arthur-wirjo/reaction-wheel-inverted-pendulum/BOM.md

### Control Board BOM

| Category | Description / Value | Manufacturer & Part Number | LCSC / Part ID | Designator | Qty |
| :--- | :--- | :--- | :--- | :--- | :--- |
| **Capacitors** | 15pF, 0603, C0G, 100V | muRata GCM1885C2A150FA16D | C882576 | C16, C17 | 2 |
| | 75pF, 0603, C0G, 50V | FOJAN FCC0603N750J500CT | C53308514 | C23 | 1 |
| | 10nF, 0603, X7R, 100V | Samsung Electro-Mechanics CL10B103KC8NNNC | C84709 | C28 | 1 |
| | 100nF, 0603, X7R, 25V | Samsung Electro-Mechanics CL10B104KA8NNNC | C1590 | C1, C5, C7, C8, C10–C15, C18–C20 | 13 |
| | 100nF, 0805, X7R, 100V | Samsung Electro-Mechanics CL21B104KCFWPNE | C307361 | C25 | 1 |
| | 1uF, 0603, X7R, 50V | Samsung Electro-Mechanics CL10B105KB8NQNC | C5199872 | C4, C6, C26, C27 | 4 |
| | 2.2uF, 0805, X7R, 25V | Samsung Electro-Mechanics CL21B225KAFNNNE | C19110 | C2, C3 | 2 |
| | 4.7uF, 1210, X7R, 50V | muRata GCM32ER71H475KA55L | C126618 | C9, C29 | 2 |
| | 10uF, 1210, X7R, 50V | Taiyo Yuden UMK325AB7106KMHP | C386166 | C24 | 1 |
| | 22uF, 1210, X7R, 25V | Samsung Electro-Mechanics CL32B226KAJNNNE | C309062 | C21, C22 | 2 |
| **Resistors** | 0Ω, 0603, Jumper | FOJAN FRC0603F0000TS | C2906974 | R2 | 1 |
| | 43Ω, 1210, 1%, 500mW | FOJAN FRC1210F43R0TS | C2999573 | R18, R19 | 2 |
| | 49.9Ω, 0603, 1%, 100mW | YAGEO RC0603FR-0749R9L | C114625 | R7 | 1 |
| | 1kΩ, 0603, 1%, 100mW | YAGEO RC0603FR-071KL | C22548 | R4, R12, R15, R16 | 4 |
| | 2.2kΩ, 0603, 1%, 200mW | UNI-ROYAL HP03W5F2201T5E | C2759425 | R13 | 1 |
| | 5.1kΩ, 0603, 1%, 100mW | YAGEO AC0603FR-075K1L | C125891 | R5, R6, R21 | 3 |
| | 10kΩ, 0603, 1%, 100mW | FH ABD03K1002FT | C5139509 | R1, R3, R17, R20, R22 | 5 |
| | 10kΩ, 0603, 1%, 200mW | YAGEO RC0603FR-7W10KL | C859110 | R14 | 1 |
| | 13.3kΩ, 0603, 1%, 100mW | UNI-ROYAL 0603WAF1332T5E | C25952 | R9 | 1 |
| | 100kΩ, 0805, 1%, 125mW | FH RS-05K1003FT | C118847 | R8 | 1 |
| | 105kΩ, 0603, 1%, 100mW | FOJAN FRC0603F1053TS | C2933128 | R11 | 1 |
| | 511kΩ, 0603, 1%, 100mW | FOJAN FRC0603F5113TS | C2930114 | R10 | 1 |
| **Inductors** | 10uH, Isat > 3.5A, Irms > 3A | TDK VLS6045EX-100M | C360734 | L1 | 1 |
| **Ferrite Bead**| 600Ω @ 100MHz, 0603 | muRata BLM18SP601SH1D | C1512133 | FB1 | 1 |
| **LEDs** | Green, 0603, SMD LED | YONGYUTAI YLED0603G | C19273151 | D2, D5 | 2 |
| | Red, 0603, SMD LED | YONGYUTAI YLED0603R | C19171390 | D3, D6 | 2 |
| | Blue, 0603, SMD LED | YONGYUTAI YLED0603B | C19171394 | D4 | 1 |
| **Crystal** | 12pF @ 25MHz | YXC Crystal Oscillators X322525MOB4SI | C9006 | - | 1 |
| **Button** | SMD-4P | XUNPU TS-1002S-05026C | C455110 | - | 3 |
| **Connectors** | XT60PW-F | - | - | - | 1 |
| | XT30PW-F | - | - | - | 1 |
| | XT30U-M | - | - | - | 1 |
| | Phoenix KF2EDGR-3.81-2P (male bent needle) | - | - | - | 1 |
| | Phoenix KF2EDGR-3.81-2P (female plug) | - | - | - | 1 |
| | 6-pin JST-GH | - | - | - | 1 |
| | 5-pin 2.54 pitch jumper | - | - | - | 1 |
| | USB-C Receptacle | HOAUC HYCW498-USBC16-735B | C42400252 | - | 1 |
| **ICs** | Microcontroller | ST STM32H743VIT6 | C114409 | - | 1 |
| | Buck Converter 24V-to-5V | TI TPS54302DDCR | C311983 | - | 1 |
| | LDO 5V-to-3.3V | MICRONE ME6211A33PG-N | C236673 | - | 1 |
| | FDCAN-compatible transceiver | ZHHXDZ TJA1051T/3/1J-HX | C53326728 | - | 1 |
| | USB ESD Protection Array | ST USBLC6-2SC6 | C7519 | - | 1 |

### Encoder Board BOM

| Category | Description / Value | Manufacturer & Part Number | LCSC / Part ID | Designator | Qty |
| :--- | :--- | :--- | :--- | :--- | :--- |
| **ICs** | Magnetic Encoder | ams AS5047P-ATSM | C962063 | - | 1 |
| **Capacitors** | 100nF, 0603, X7R, 25V | Samsung Electro-Mechanics CL10B104KA8NNNC | C1590 | C1 | 1 |
| | 1uF, 0603, X7R, 50V | Samsung Electro-Mechanics CL10B105KB8NQNC | C5199872 | C2 | 1 |
| **Resistors** | 0Ω, 0603, Jumper | FOJAN FRC0603F0000TS | C2906974 | R1 | 1 |
| | 10kΩ, 0603, 1%, 100mW | FH ABD03K1002FT | C5139509 | R2, R3, R4 | 3 |
| **Connectors** | 6-pin JST-GH | - | - | - | 1 |
| | 6-pin JST-PH | - | - | - | 1 |

### Other Components (Cables, Motor, Mechanical)

| Category | Description / Value | Qty |
| :--- | :--- | :--- |
| **Cables** | 6-pin JST-GH (one sided) | 1 |
| | 6-pin JST-PH (double sided) | 1 |
| | 4-pin JST-PH (one sided) | 1 |
| | 4 wire Slip Ring, 10A rating | 1 |
| **Motor, ESC, Power** | TianYi 4006 380Kv drone BLDC motor | 1 |
| | Flipsky Mini VESC 6.7 Pro | 1 |
| **Mechanical** | Bearing 608-ZZ | 1 |
| | Main rig (3D printed with PLA/PLA+) | 1 |
