arthur-wirjo/reaction-wheel-inverted-pendulum/BOM_and_Schematics/control_board_PCB.csv

Reference | Qty | Value | Description | Manufacturer | MPN | LCSC | Footprint
C1, C5, C7, C8, C10, C11, C12, C13, C14, C15, C18, C19, C20 | 13 | 100nF | 0603, X7R, 25V | Samsung Electro-Mechanics | CL10B104KA8NNNC | C1590 | C_0603_1608Metric
C2, C3 | 2 | 2.2uF | 0805, X7R, 25V | Samsung Electro-Mechanics | CL21B225KAFNNNE | C19110 | C_0805_2012Metric
C4, C6, C26, C27 | 4 | 1uF | 0603, X7R, 50V | Samsung Electro-Mechanics | CL10B105KB8NQNC | C5199872 | C_0603_1608Metric
C9, C29 | 2 | 4.7uF | 1210, X7R, 50V | muRata | GCM32ER71H475KA55L | C126618 | C_1210_3225Metric
C16, C17 | 2 | 15pF | 0603, C0G, 100V | muRata | GCM1885C2A150FA16D | C882576 | C_0603_1608Metric
C21, C22 | 2 | 22uF | 1210, X7R, 25V | Samsung Electro-Mechanics | CL32B226KAJNNNE | C309062 | C_1210_3225Metric
C23 | 1 | 75pF | 0603, C0G, 50V | FOJAN | FCC0603N750J500CT | C53308514 | C_0603_1608Metric
C24 | 1 | 10uF | 1210, X7R, 50V | Taiyo Yuden | UMK325AB7106KMHP | C386166 | C_1210_3225Metric
C25 | 1 | 100nF | 0805, X7R, 100V | Samsung Electro-Mechanics | CL21B104KCFWPNE | C307361 | C_0805_2012Metric
C28 | 1 | 10nF | 0603, X7R, 100V | Samsung Electro-Mechanics | CL10B103KC8NNNC | C84709 | C_0603_1608Metric
CN1 | 1 | KF2EDGR-3.81-2P | Pluggable Terminal Block Header, 2-Pin, 3.81mm, Right Angle, THT | Cixi Kefa Elec | KF2EDGR-3.81-2P | C441182 | Phoenix_CONN-TH_2P-P3.81_KF2EDGR-3.81-2P
D1 | 1 | USBLC6-2SC6 | USB ESD Protection Array, SOT-23-6L | STMicroelectronics | USBLC6-2SC6 | C7519 | ESD_SOT-23-6
D2, D5 | 2 | Green | Green SMD LED, 0603 | YONGYUTAI | YLED0603G | C19273151 | LED_0603_1608Metric
D3, D6 | 2 | Red | Red SMD LED, 0603 | YONGYUTAI | YLED0603R | C19171390 | LED_0603_1608Metric
D4 | 1 | Blue | Blue SMD LED, 0603 | YONGYUTAI | YLED0603B | C19171394 | LED_0603_1608Metric
FB1 | 1 | 600Ω @ 100MHz | Ferrite Bead, 0603 | muRata | BLM18SP601SH1D | C1512133 | L_0603_1608Metric
J1 | 1 | SM06B-GHS-TBLFSN | 6-pin JST-GH Male Header (SMD) | JST | SM06B-GHS-TB(LF)(SN) | - | CONN_SM06B-GHS-TB_JST
J3 | 1 | Conn_01x05_Pin | 2.54mm pitch 5-pin male header, Horizontal | Generic | - | - | PinHeader_1x05_P2.54mm_Horizontal
L1 | 1 | 10uH | Shielded Power Inductor, Isat 3.9A, Irms 3.4A, 6x6mm | TDK | VLS6045EX-100M | C360734 | IND-SMD_L6.0-W6.0
R1, R3, R17, R20, R22 | 5 | 10kΩ | 0603, 1%, 100mW | FH | ABD03K1002FT | C5139509 | R_0603_1608Metric
R2 | 1 | 0Ω | 0603, Jumper | FOJAN | FRC0603F0000TS | C2906974 | R_0603_1608Metric
R4, R12, R15, R16 | 4 | 1kΩ | 0603, 1%, 100mW | YAGEO | RC0603FR-071KL | C22548 | R_0603_1608Metric
R5, R6, R21 | 3 | 5.1kΩ | 0603, 1%, 100mW | YAGEO | AC0603FR-075K1L | C125891 | R_0603_1608Metric
R7 | 1 | 49.9Ω | 0603, 1%, 100mW | YAGEO | RC0603FR-0749R9L | C114625 | R_0603_1608Metric
R8 | 1 | 100kΩ | 0805, 1%, 125mW | FH | RS-05K1003FT | C118847 | R_0805_2012Metric
R9 | 1 | 13.3kΩ | 0603, 1%, 100mW | UNI-ROYAL | 0603WAF1332T5E | C25952 | R_0603_1608Metric
R10 | 1 | 511kΩ | 0603, 1%, 100mW | FOJAN | FRC0603F5113TS | C2930114 | R_0603_1608Metric
R11 | 1 | 105kΩ | 0603, 1%, 100mW | FOJAN | FRC0603F1053TS | C2933128 | R_0603_1608Metric
R13 | 1 | 2.2kΩ | 0603, 1%, 200mW | UNI-ROYAL | HP03W5F2201T5E | C2759425 | R_0603_1608Metric
R14 | 1 | 10kΩ | 0603, 1%, 200mW | YAGEO | RC0603FR-7W10KL | C859110 | R_0603_1608Metric
R18, R19 | 2 | 43Ω | 1210, 1%, 500mW | FOJAN | FRC1210F43R0TS | C2999573 | R_1210_3225Metric
SW1, SW2, SW3 | 3 | TS-1002S-05026C | Tactile Switch, SPST, SMD-4P, 6x6x5mm | XUNPU | TS-1002S-05026C | C455110 | BTN_KEY-SMD_4P-L6.0-W6.0
U1 | 1 | STM32H743VIT6 | 32-bit ARM Cortex-M7 MCU, LQFP-100 | STMicroelectronics | STM32H743VIT6 | C114409 | MCU_LQFP100-14x14mm
U2 | 1 | TJA1051T/3/1J-HX | FDCAN-Compatible High-Speed CAN Transceiver, SOIC-8 | ZHHXDZ | TJA1051T/3/1J-HX | C53326728 | CAN_SOP-8
U3 | 1 | ME6211A33PG-N | LDO 5V-to-3.3V Voltage Regulator, 500mA, SOT-89 | MICRONE | ME6211A33PG-N | C236673 | LDO_SOT-89
U4 | 1 | XT60PW-F | XT60 PCB Power Connector, Female, Right Angle, THT | Changzhou Amass Elec | XT60PW-F | C428722 | XT60_TH_2P-XT60PW-F
U5 | 1 | TPS54302DDCR | Buck Converter 24V-to-5V, 3A, TSOT-23-6 | Texas Instruments | TPS54302DDCR | C311983 | BUCK_SOT-23-6
U6 | 1 | XT30PW-F | XT30 PCB Power Connector, Female, Right Angle, THT | Changzhou Amass Elec | XT30PW-F20.G.Y | C2913282 | CONN-TH_XT30PW-F-1
USB1 | 1 | HYCW498-USBC16-735B | USB-C Receptacle (USB 2.0, 16-pin, SMD) | HOAUC | HYCW498-USBC16-735B | C42400252 | USB-C-SMD_HYCW498-USBC16-735B
X1 | 1 | 25MHz | 25MHz SMD Crystal, 12pF, 3.2x2.5mm, 4-Pin | YXC | X322525MOB4SI | C9006 | CRYSTAL-SMD_4P-L3.2-W2.5-BL
