arthur-wirjo/reaction-wheel-inverted-pendulum/BOM_and_Schematics/encoder_board_PCB.csv

Reference | Qty | Value | Description | Manufacturer | MPN | LCSC | Footprint
C1 | 1 | 100nF | 0603, X7R, 25V | Samsung Electro-Mechanics | CL10B104KA8NNNC | C1590 | C_0603_1608Metric
C2 | 1 | 1uF | 0603, X7R, 50V | Samsung Electro-Mechanics | CL10B105KB8NQNC | C5199872 | C_0603_1608Metric
J1 | 1 | S6B-PH-SM4-TBLFSN | 6-pin JST-PH Male Header (SMD) | JST | S6B-PH-SM4-TB(LF)(SN) | - | CONN6_S6B-PH_JST
J2 | 1 | SM06B-GHS-TBLFSN | 6-pin JST-GH Male Header (SMD) | JST | SM06B-GHS-TB(LF)(SN) | - | CONN_SM06B-GHS-TB_JST
R1 | 1 | 0Ω | 0603, Jumper | FOJAN | FRC0603F0000TS | C2906974 | R_0603_1608Metric
R2, R3, R4 | 3 | 10kΩ | 0603, 1%, 100mW | FH | ABD03K1002FT | C5139509 | R_0603_1608Metric
U1 | 1 | AS5047P-ATSM | 14-bit Magnetic Rotary Position Sensor, TSSOP-14 | ams OSRAM | AS5047P-ATSM | C962063 | ENC_TSSOP14_OSM
