arthur-wirjo/reaction-wheel-inverted-pendulum/Mechanical_Design/Assembly.SLDASM

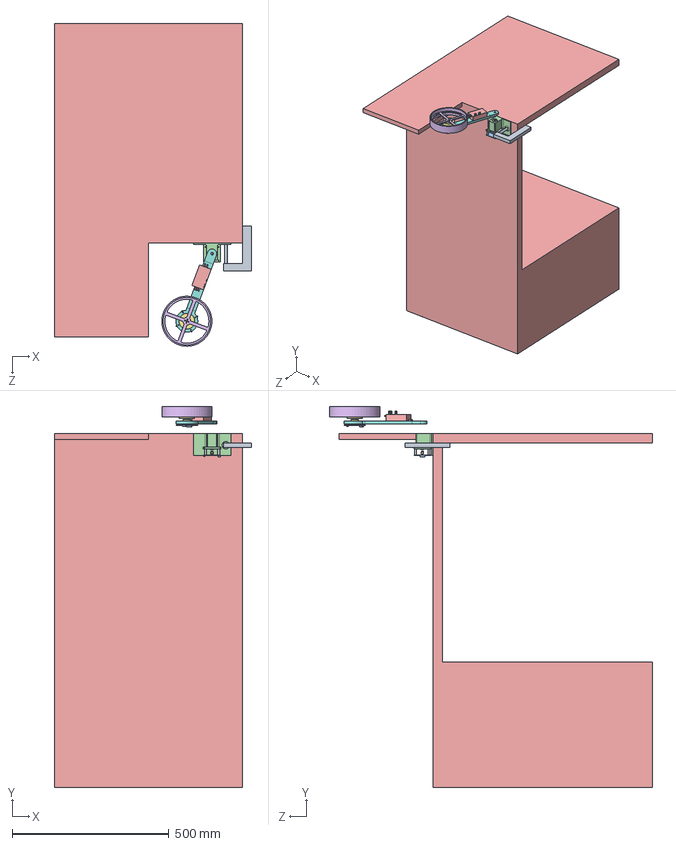
[picture p1: CAD file, 2026-11-14]
Mechanical_Design/Assembly.SLDASM
630.0 x 1216.0 x 1029.5 mm
Table
Base
bearing_spacer_01
SKF_608-2ZZ x 2
clamp
Arm
Motor
Wheel
VESC
encodeer_spacer_01 x 4
encoder board PCB x 2
magnet_coupler_SPI
encoder_spacer_02 x 4
