arthur-wirjo/reaction-wheel-inverted-pendulum/Component_EDA_Models/MagEnc_AS5047P/TSSOP14_OSM.step

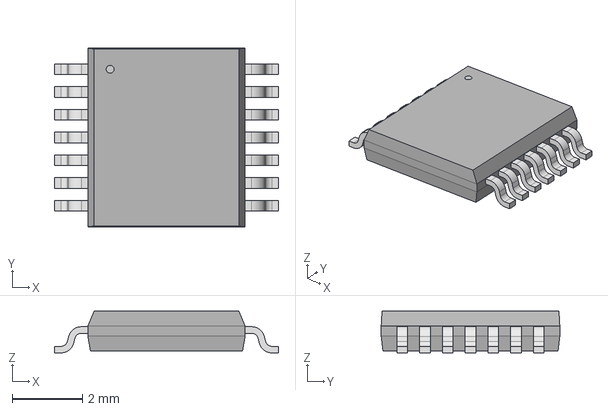
[picture p2: CAD file, 2026-10-11]
Component_EDA_Models/MagEnc_AS5047P/TSSOP14_OSM.step
6.40 x 5.11 x 1.20 mm
