arthur-wirjo/reaction-wheel-inverted-pendulum/Component_EDA_Models/STM32H743VIT6/LQFP100-14x14mm.step

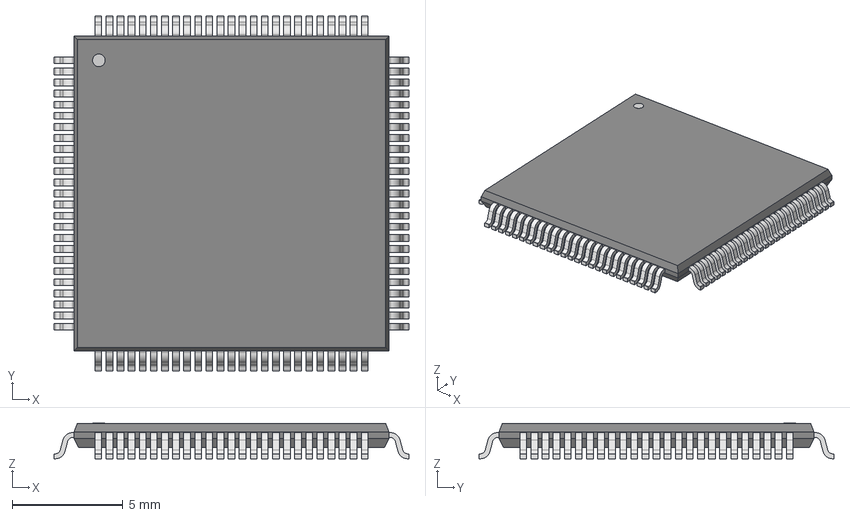
[picture p3: CAD file, 2026-10-11]
Component_EDA_Models/STM32H743VIT6/LQFP100-14x14mm.step
16.0 x 16.0 x 1.60 mm
