arthur-wirjo/reaction-wheel-inverted-pendulum/Mechanical Design/3D Prints/magnet_coupler_SPI.STEP

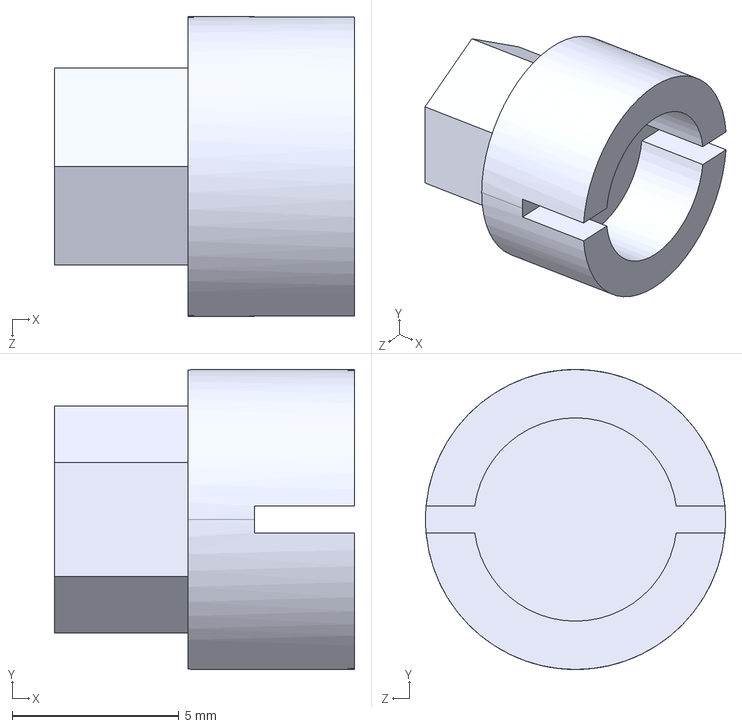
[picture p4: CAD file, 2026-11-08]
Mechanical Design/3D Prints/magnet_coupler_SPI.STEP
9.00 x 9.00 x 9.00 mm
