arthur-wirjo/reaction-wheel-inverted-pendulum/Mechanical Design/bearing_spacer_01.SLDPRT

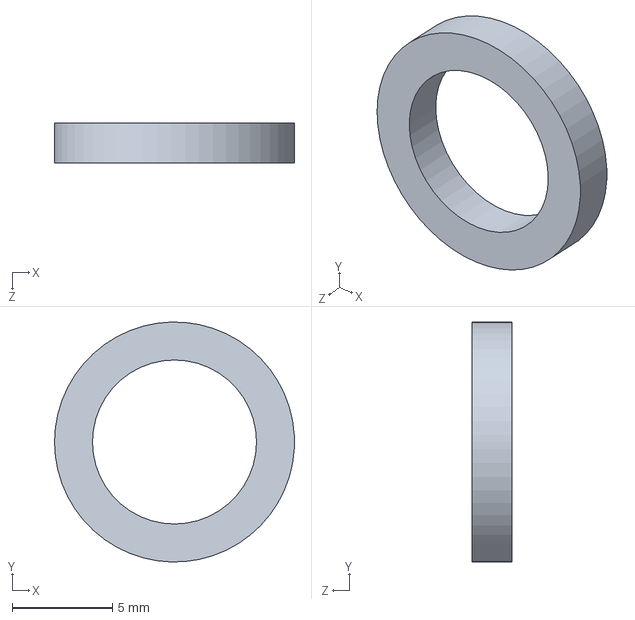
[picture p5: CAD file, 2026-11-08]
Mechanical Design/bearing_spacer_01.SLDPRT
12.0 x 12.0 x 2.00 mm
