arthur-wirjo/reaction-wheel-inverted-pendulum/Mechanical_Design/3D Prints/4X_encodeer_spacer_01.STEP

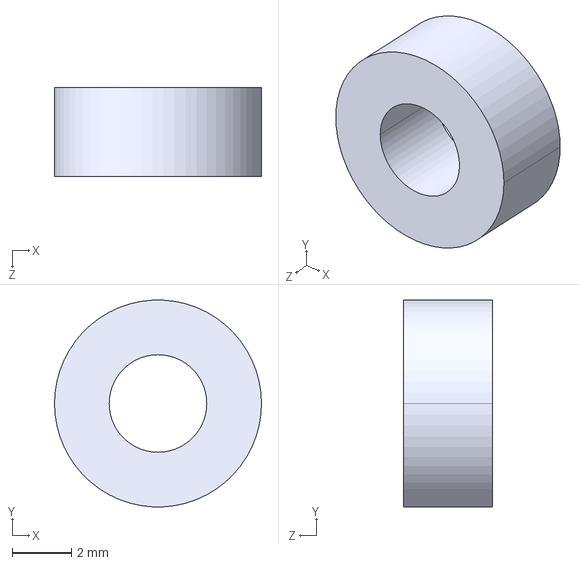
[picture p6: CAD file, 2026-11-14]
Mechanical_Design/3D Prints/4X_encodeer_spacer_01.STEP
7.00 x 6.99 x 3.00 mm
