arthur-wirjo/reaction-wheel-inverted-pendulum/Mechanical Design/3D Prints/Wheel.STEP

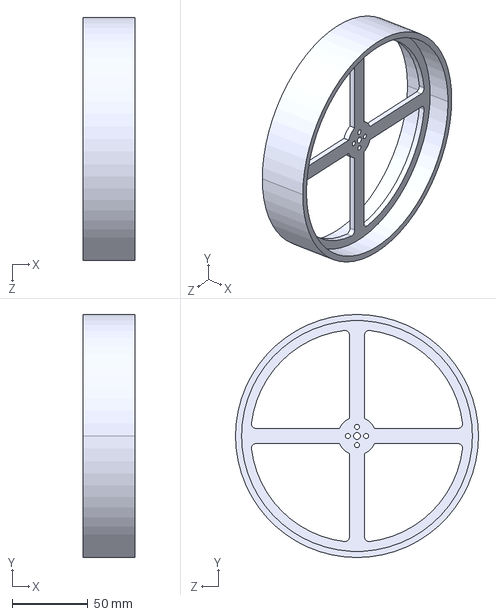
[picture p7: CAD file, 2026-11-08]
Mechanical Design/3D Prints/Wheel.STEP
34.0 x 160.0 x 160.0 mm
