arthur-wirjo/reaction-wheel-inverted-pendulum/Mechanical_Design/3D Prints/Base.STEP

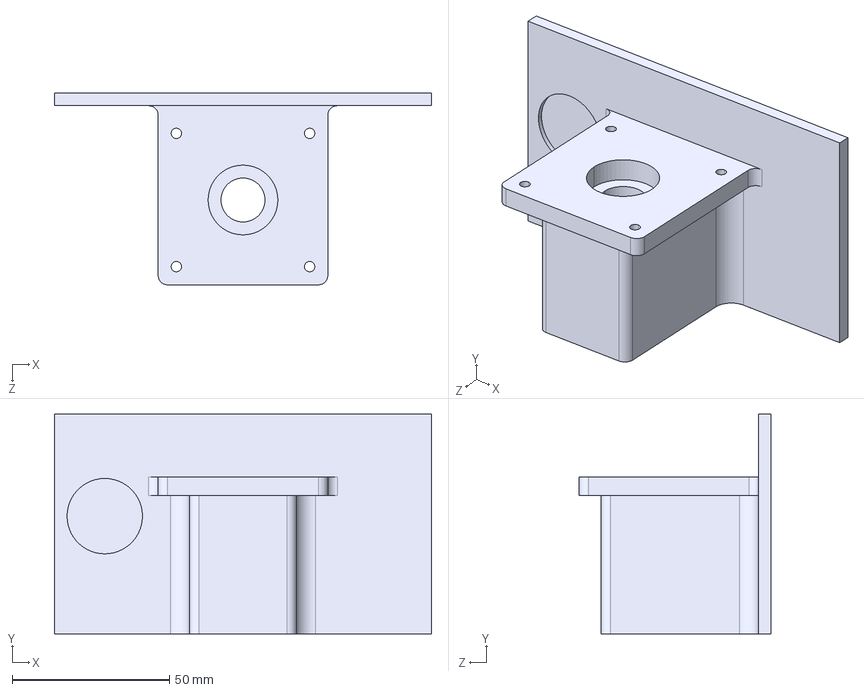
[picture p8: CAD file, 2026-11-14]
Mechanical_Design/3D Prints/Base.STEP
120.0 x 70.0 x 61.0 mm
