arthur-wirjo/reaction-wheel-inverted-pendulum/Mechanical Design/3D Prints/Arm.STEP

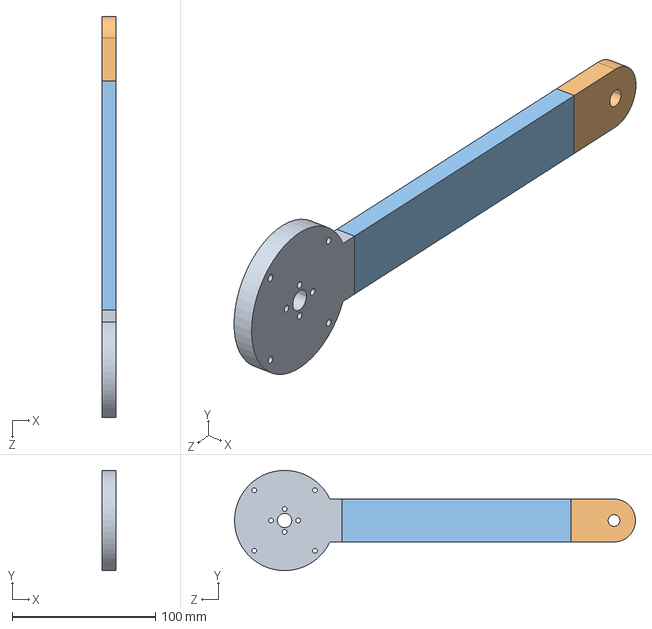
[picture p9: CAD file, 2026-11-08]
Mechanical Design/3D Prints/Arm.STEP
10.0 x 70.0 x 280.0 mm
