arthur-wirjo/reaction-wheel-inverted-pendulum/Mechanical_Design/clamp.SLDPRT

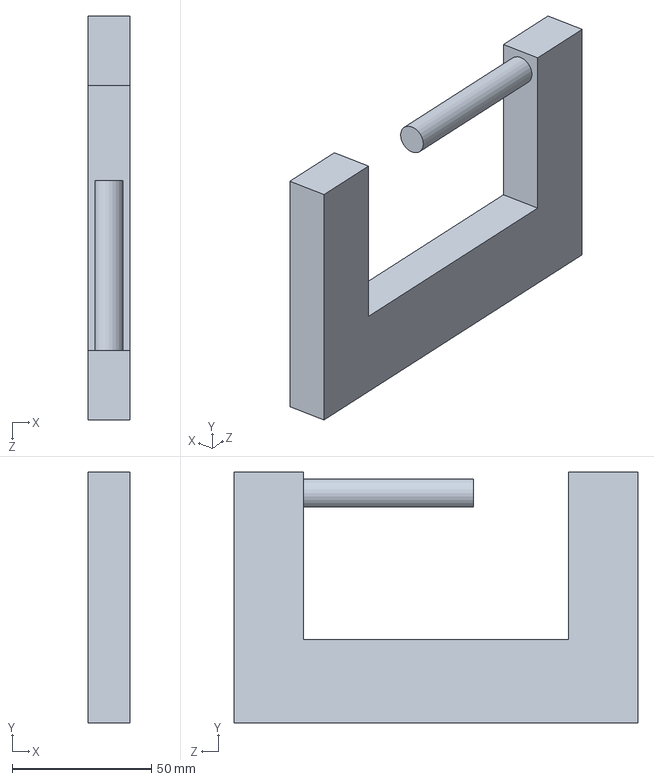
[picture p10: CAD file, 2026-11-14]
Mechanical_Design/clamp.SLDPRT
15.0 x 90.0 x 145.0 mm
