arthur-wirjo/reaction-wheel-inverted-pendulum/Mechanical Design/3D Prints/magnet coupler_ABI.STEP

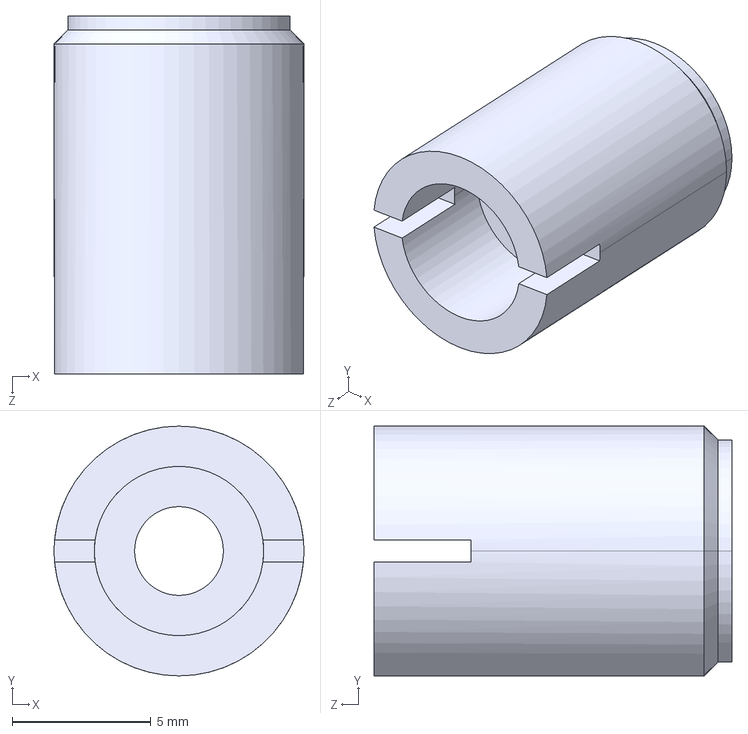
[picture p11: CAD file, 2026-11-08]
Mechanical Design/3D Prints/magnet coupler_ABI.STEP
9.00 x 9.00 x 12.9 mm
