arthur-wirjo/reaction-wheel-inverted-pendulum/Mechanical Design/encoder_spacer_02.SLDPRT

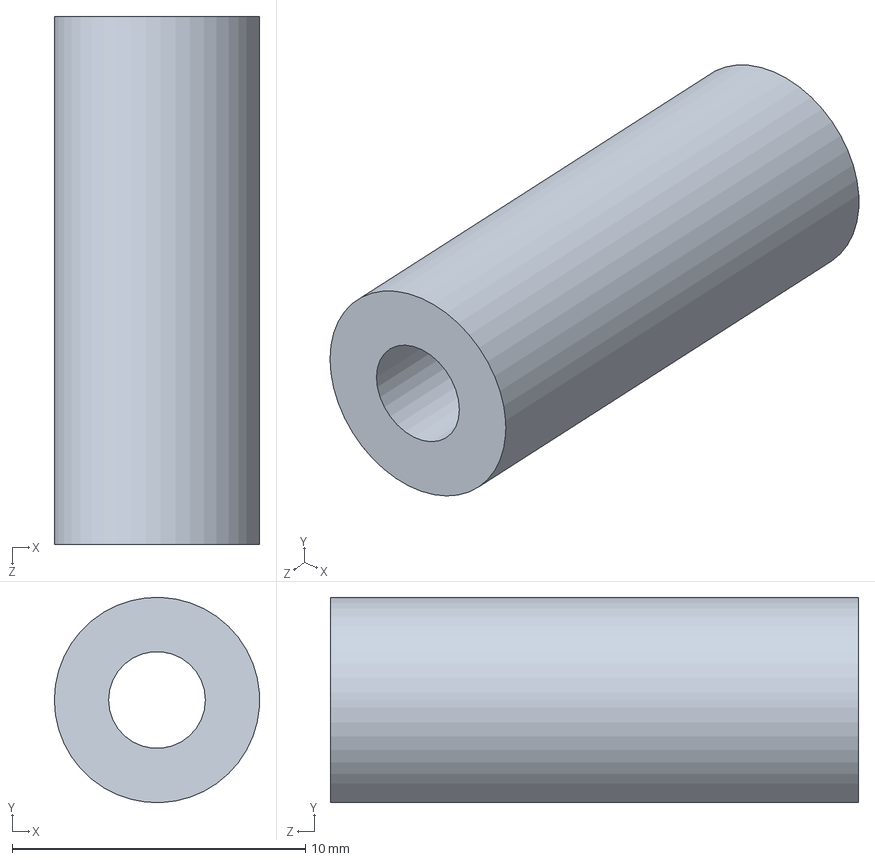
[picture p12: CAD file, 2026-11-08]
Mechanical Design/encoder_spacer_02.SLDPRT
7.00 x 7.00 x 18.0 mm
