arthur-wirjo/reaction-wheel-inverted-pendulum/Mechanical_Design/3D Prints/bearing_spacer_02.STEP

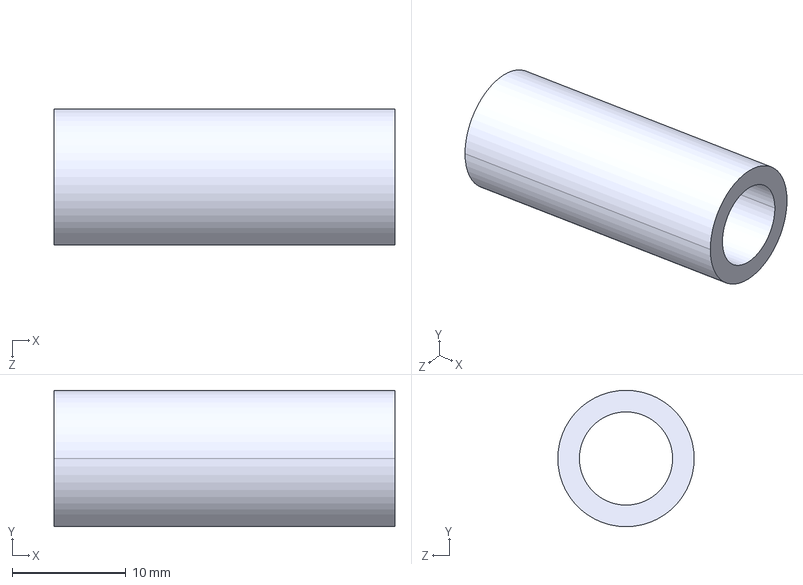
[picture p13: CAD file, 2026-11-14]
Mechanical_Design/3D Prints/bearing_spacer_02.STEP
30.0 x 12.0 x 12.0 mm
