arthur-wirjo/reaction-wheel-inverted-pendulum/Mechanical Design/VESC.SLDPRT

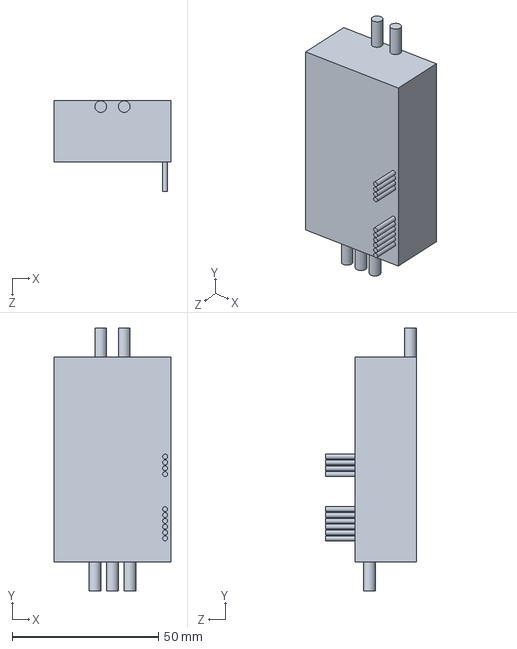
[picture p14: CAD file, 2026-10-16]
Mechanical Design/VESC.SLDPRT
40.0 x 90.0 x 31.0 mm
