arthur-wirjo/reaction-wheel-inverted-pendulum/Mechanical Design/encoder board PCB.SLDPRT

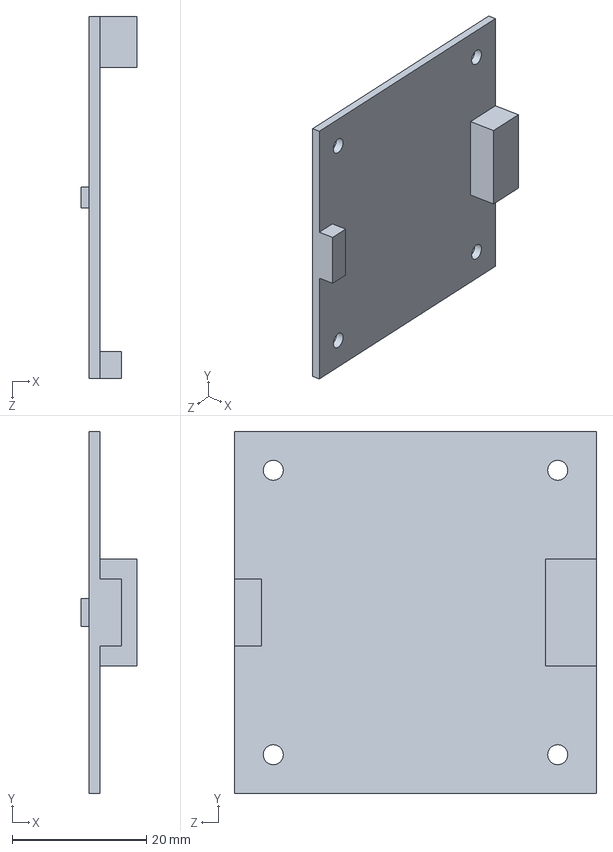
[picture p15: CAD file, 2026-10-16]
Mechanical Design/encoder board PCB.SLDPRT
8.30 x 54.0 x 54.0 mm
