arthur-wirjo/reaction-wheel-inverted-pendulum/Mechanical Design/magnet coupler.SLDPRT

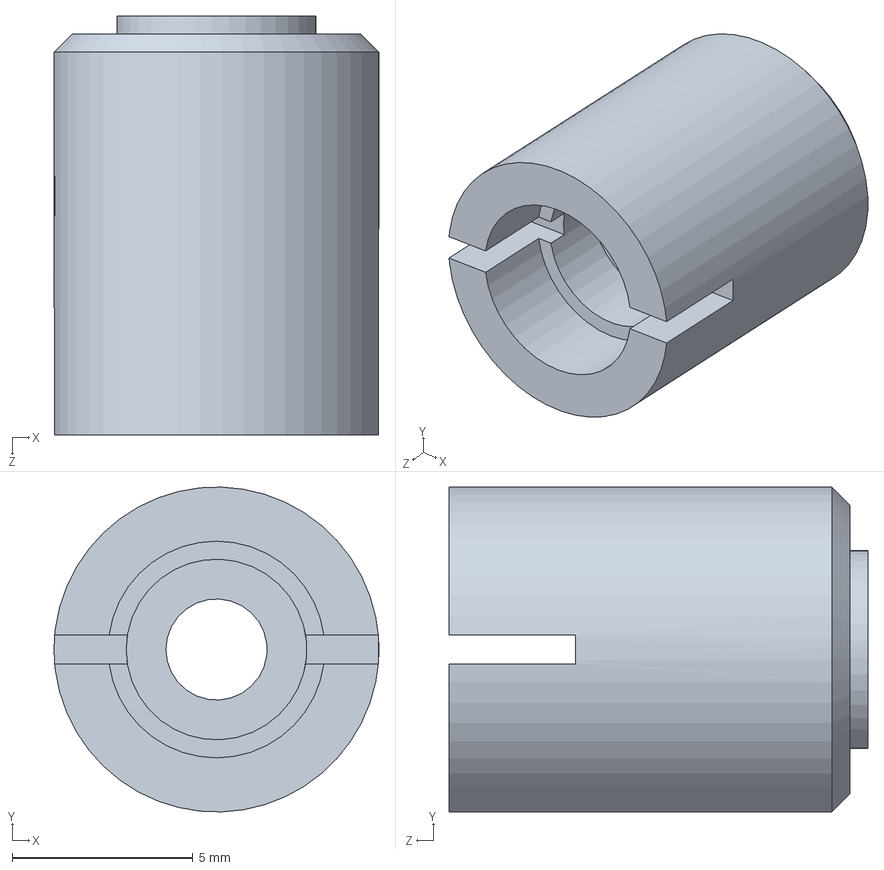
[picture p16: CAD file, 2026-10-16]
Mechanical Design/magnet coupler.SLDPRT
9.00 x 8.99 x 11.6 mm
