arthur-wirjo/reaction-wheel-inverted-pendulum/Mechanical Design/Table.SLDPRT

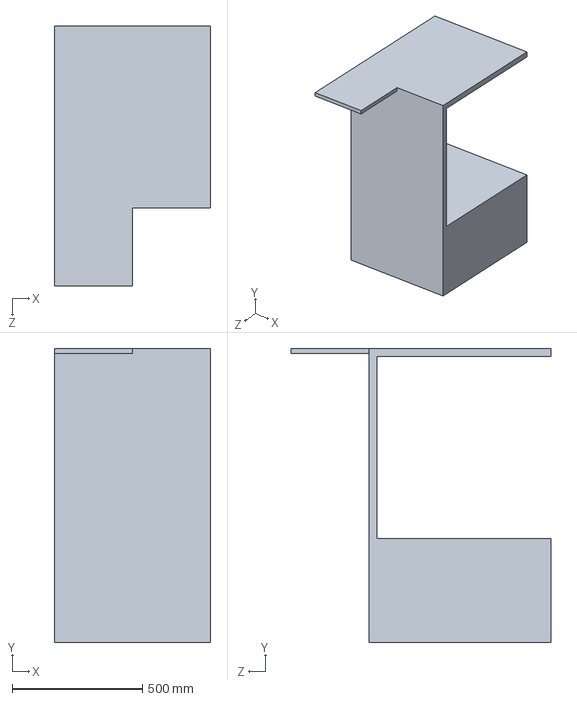
[picture p17: CAD file, 2026-10-16]
Mechanical Design/Table.SLDPRT
600.0 x 1130.0 x 1000.0 mm
