arthur-wirjo/reaction-wheel-inverted-pendulum/Mechanical Design/Motor.SLDPRT

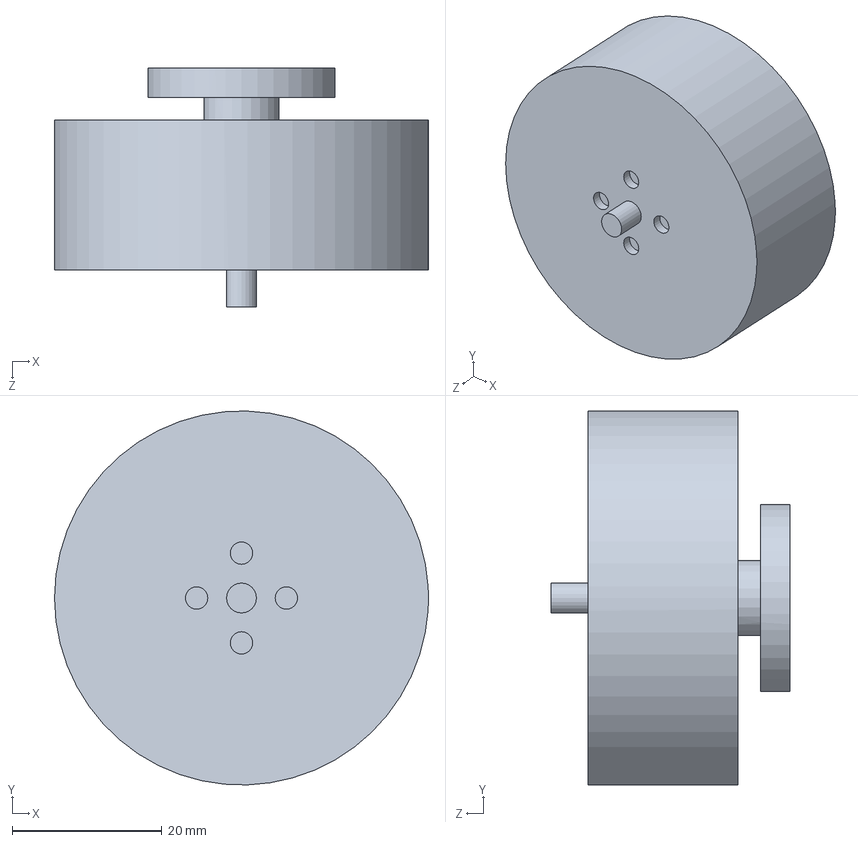
[picture p18: CAD file, 2026-10-16]
Mechanical Design/Motor.SLDPRT
50.0 x 50.0 x 32.0 mm
