arthur-wirjo/reaction-wheel-inverted-pendulum/Mechanical Design/SKF_608-2ZZ.SLDPRT

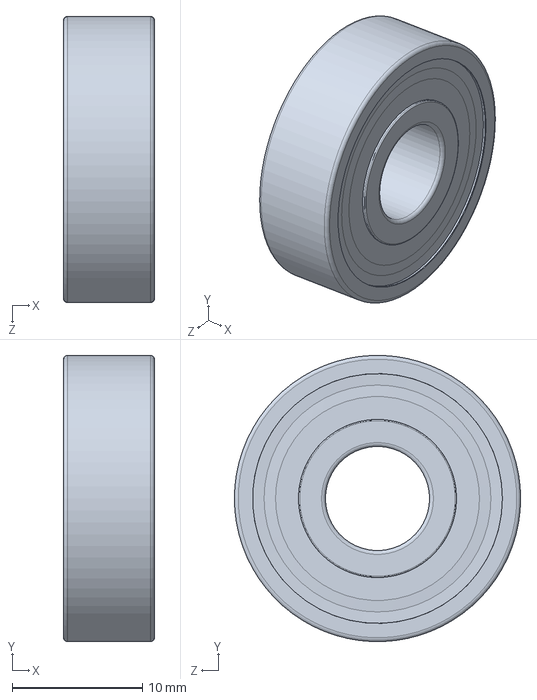
[picture p19: CAD file, 2026-10-16]
Mechanical Design/SKF_608-2ZZ.SLDPRT
7.00 x 22.0 x 22.0 mm
