arthur-wirjo/reaction-wheel-inverted-pendulum/(list of files, cad)

Other CAD files:
Mechanical Design/Assembly.SLDASM
Mechanical_Design/magnet_coupler_SPI.SLDPRT
Mechanical Design/Base.SLDPRT
Mechanical_Design/3D Prints/bearing_spacer_01.STEP
Mechanical_Design/Arm.SLDPRT
Mechanical Design/3D Prints/4X_encoder_spacer_02.STEP
Mechanical_Design/Wheel.SLDPRT
Mechanical Design/encodeer_spacer_01.SLDPRT
Mechanical Design/Arm.SLDPRT
Mechanical Design/Wheel.SLDPRT
Mechanical Design/magnet_coupler_ABI.SLDPRT
Mechanical Design/screw_M8.SLDPRT
Mechanical_Design/bearing_spacer_02.SLDPRT
Mechanical_Design/nut_M8.SLDPRT
