arthur-wirjo/reaction-wheel-inverted-pendulum/Firmware_STM32H7/Firmware_STM32H7.ioc

Mcu.UserName=STM32H743VITx
PA11.Signal=USB_OTG_FS_DM
PA12.Signal=USB_OTG_FS_DP
PA5.Signal=SPI1_SCK
PA6.Signal=SPI1_MISO
PA7.Signal=SPI1_MOSI
PA9.Signal=USB_OTG_FS_VBUS
PB9.GPIO_Label=USER_BTN
PB9.Signal=GPIO_Input
PC4.GPIO_Label=SPI1_CS
PC4.Signal=GPIO_Output
PD0.Signal=FDCAN1_RX
PD1.Signal=FDCAN1_TX
PD5.GPIO_Label=LED_Red
PD5.Signal=GPIO_Output
PD7.GPIO_Label=LED_Green
PD7.Signal=GPIO_Output
