arthur-wirjo/reaction-wheel-inverted-pendulum/Firmware_STM32H7/Core/Inc/main.h

#define SPI1_CS_Pin GPIO_PIN_4
#define SPI1_CS_GPIO_Port GPIOC
#define LED_Red_Pin GPIO_PIN_5
#define LED_Red_GPIO_Port GPIOD
#define LED_Green_Pin GPIO_PIN_7
#define LED_Green_GPIO_Port GPIOD
#define USER_BTN_Pin GPIO_PIN_9
#define USER_BTN_GPIO_Port GPIOB
