arthur-wirjo/reaction-wheel-inverted-pendulum/(commit log)

2026-10-11 sourced main kicad components
2026-10-13 control board PCB v1 done
2026-10-15 control board and encoder board schematic done and components sourced and bought
2026-10-16 mechanical setup designed and encoder PCB layout done
2026-10-17 control board PCB layout done and gerber files generated
2026-11-04 gitignored kicad .history directory
2026-11-08 added BOM_and_Schematic directory and added schematic pdf
2026-11-11 firmware configuration and hardware like SPI encoder, LEDs, buttons, and MCU validated. Moving on to CAN Bus communication with VESC
2026-11-12 stm32h7 CAN Bus communication with VESC successfully established
2026-11-12 PID control implemented but encountered 24V regenerative braking voltage spike during initial PID testing, destroying the buck converter. Will design new PCB with protection and higher voltage rated 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
2026-11-13 control board V1.1 schematic done
2026-11-14 PCB V1.1 layout done, gerber files generated
